MikhailBerezhanov/FLC-01/pcb/ver03/Project Outputs for FitoLamp_Project/FLC-01v3_BOM.xls

Comment | Description | Designator | Quantity
0805 0.1uF | SMD Cap 0805 | C1, C16, C17, C19, C20, C21, C22 | 7
1206 1000V 100pF | SMD Cap 1206 | C2 | 1
TECAP_A 35V 0.1uF | Tantalum pol cap type A | C3, C4, C5, C6, C7 | 5
K50-35 63V 47uF | Конденсатор электролитический алюминиевый | C8, C23, C24, C25 | 4 | https://www.chipdip.ru/product0/9000565883
1210 1uF X7R 100V | Cap SMD1210 | C9, C26, C27, C28 | 4 | https://www.chipdip.ru/product/grm32er72a105k
K50-35 35V 220uF | Конденсатор электролитический алюминиевый | C10 | 1 | https://www.chipdip.ru/product0/9000565883
0805 1uF 25V X7R | SMD Cap 0805 | C11 | 1 | https://www.chipdip.ru/product/grm21br71e105k
0805 15pF | SMD Cap 0805 | C12, C14 | 2
TECAP_B 47uF 10V | Tantalum pol cap type B | C13 | 1 | https://www.chipdip.ru/product0/366405224
0805 22pF | SMD Cap 0805 | C15, C18 | 2
ADM3202ARNZ | 3.3V SMD RS232-UART | D1 | 1
STM32F103C8T6 | ARM Cortex-M3 32-bit MCU, 64 KB Flash, 20 KB Internal RAM, 37 I/Os, 48-pin LQFP, -40 to 85 degC, Tray | D2 | 1 | https://www.chipdip.ru/product/stm32f103c8t6
LM2596HV-ADJ | SIMPLE SWITCHER4; 4V to 60V, 3A Low Component Count Step-Down Regulator | DA1 | 1 | https://www.chipdip.ru/product/lm2596hvgr-adj
MC33269DT-3.3G | 800mA,3.3V,LDO Voltage Reg,MC33269DT-3.3 MC33269DT-3.3G, Low Dropout Voltage Regulator, 0.8A, 3.3 V 1%, 3-Pin DPAK | DA2 | 1 | https://www.chipdip.ru/product/mc33269dt-3.3g
LDD-H | LED Power Supplies | DA3, DA4, DA5 | 3
HM10 | BLE4.0-module | DD1 | 1
LED_0_25_4 | Throw Hole 3mm diameter LED | HL1, HL2 | 2
BK-912-TR | Holder Coin Cell 20mm Smd | J1 | 1
RLB0914-470KL | Радиальные выводные индуктивности | L1, L3, L4, L5 | 4 | https://www.chipdip.ru/product/rlb0914-470kl
SRR1208-330YL | Fixed Inductors 6800uH 10% SMD 1208 | L2 | 1 | https://www.chipdip.ru/product/srr1208-330yl
1206 1M | SMD Res 1206 | R1 | 1
0805 10k | SMD Res 0805 | R2, R3, R7, R8, R9, R10, R11, R12 | 8
0805 51k 1% | SMD Res 0805 | R4 | 1 | https://www.chipdip.ru/product0/9000079531?from=suggest_product
0805 4.7k 1% | SMD Res 0805 | R5 | 1
0805 1M | SMD Res 0805 | R6 | 1
0805 130 1% | SMD Res 0805 | R13 | 1
0805 470 1% | SMD Res 0805 | R14 | 1
1437566-3 | SMD button | S1 | 1
SS36 | Rectifier, Schottky; DO-214AB; 3.0A IF; 0.75V; 60V; 100A IFRM; 10000V/us; 1000pF | VD1 | 1 | https://www.chipdip.ru/product/ss36-e3-57t-2
SS26T3G | Диод Шоттки 2А 60В [SMB / DO-214AA] | VD2 | 1 | https://www.chipdip.ru/product/ss26t3g
BAT54C | Small Signal Schottky Diode, Dual Common Cathode, 30 V, 200 mA, 400 mV, 600 mA, 125 C | VD3 | 1 | https://www.chipdip.ru/product/bat54c-diotec
DS-201 | Гнездо питания 2,1х5,5на плату | X1 | 1
300-021-12 | Klemmnik 2 | X2 | 1 | https://www.chipdip.ru/product/300-021-12
DS1021_1x4 | Вилка штыревая 2.54мм 1x4 прямая тип1 | X3, X5 | 2
DRB- 9FA | DRB- 9FA (DS1037-9F) | X4 | 1
DS1021_1x3 | Вилка штыревая 2.54мм 1x3 прямая тип1 | X6 | 1
DS1069-6M | Вилка Dip угловая, шаг 2.50мм Номинальный ток: 3А АС, DC Max | X7 | 1 | https://www.chipdip.ru/product/cwf-6r
309-021-12 | DG390-5.0-02P (XY118-2P-05) Зажимной Клеммник 2-контактный, 5.0мм угловой | X8, X9, X10 | 3
DT-26 32,768 12.5pF | 32,768 кГц имп. цил.2x6мм, DT-26, Кварцевый резонатор 12.5pF | Y1 | 1 | https://www.chipdip.ru/product/32768hz-2x6mm
DT-38 32,768kHz 12/5pF | 32,768 кГц имп. цил.3x8мм DT-38, Кварцевый резонатор 12/5pF | Y2 | 1 | https://www.chipdip.ru/product/32768hz-dt-38t
FC135-32768-12.5pF | Clock SMD Crystal | Y3 | 1
HC49SM-8MHz | HC49SM | Y4 | 1 | https://www.chipdip.ru/product/8mhz-hc-49sm
