MikhailBerezhanov/FLC-01/pcb/TODO.txt

1. Добавить резисторы-подтяжки к земле на ШИМ каналы
