MikhailBerezhanov/FLC-01/(list of files, drawings)

Other design files:
pcb/ver03/FitoLamp_Project.PrjPcb
pcb/ver03/fitolamp_shc.SchDoc
pcb/ver03/MyLogo.PcbDoc
